sudarkoff/thermostat/eagle/board.png

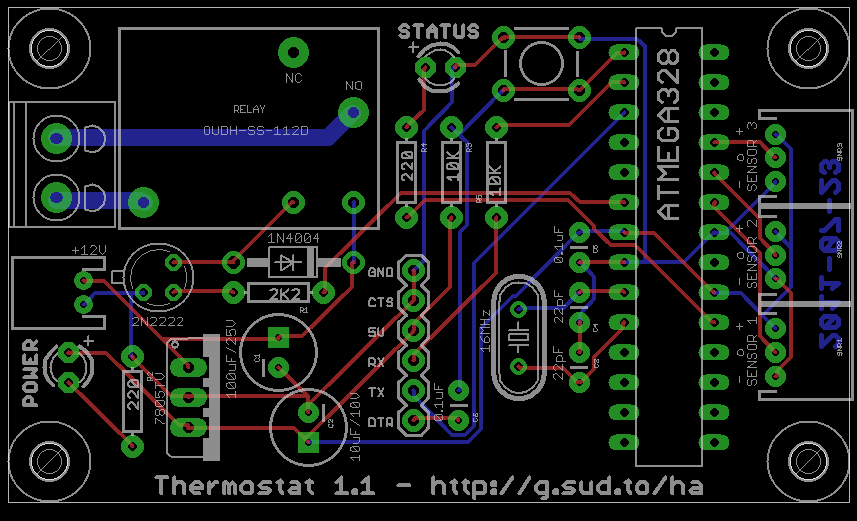
eagle/board.png
