sudarkoff/thermostat/eagle/schematics.png

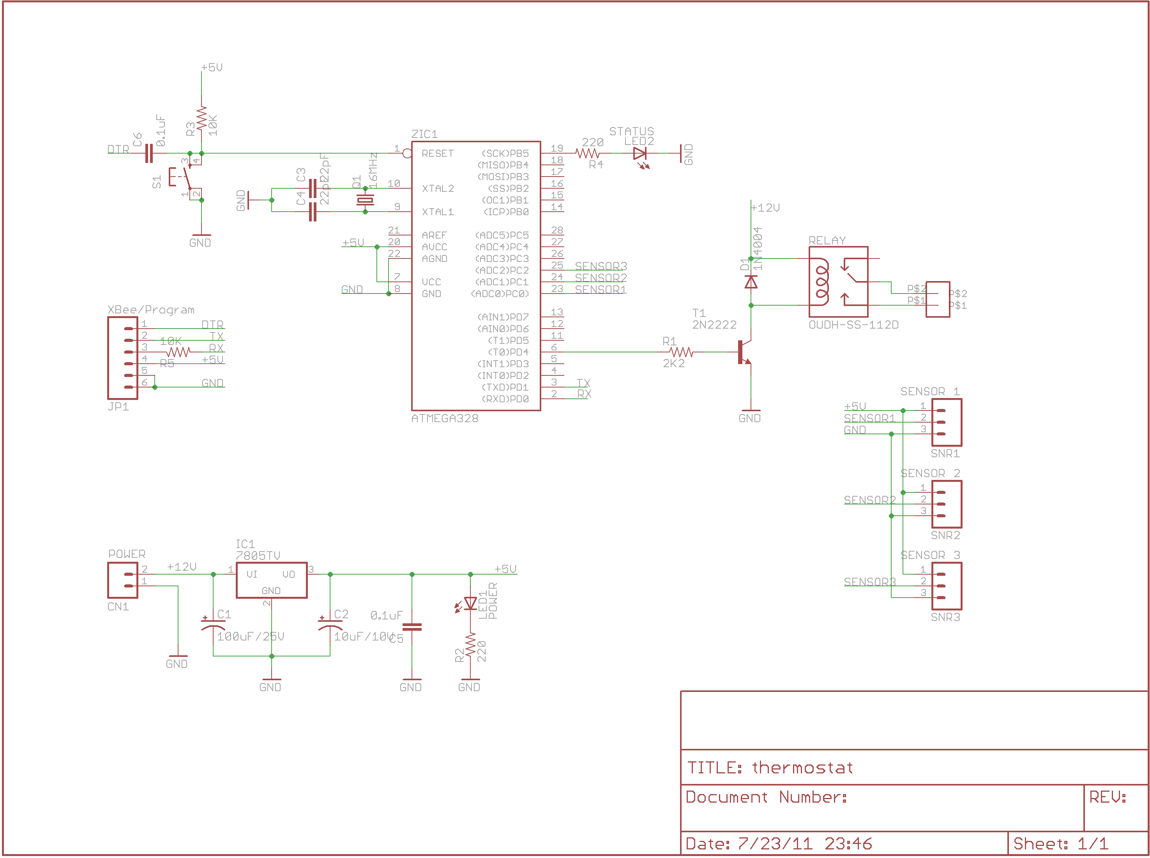
eagle/schematics.png
