sudarkoff/thermostat/(commit log)

2011-07-08 XBeeThermostat V1.0 (PCB ordered from batchpcb.com for proofing and stuff).
    [thermostat.brd, thermostat.sch]
2011-07-09 Committed a bunch of stuff for the first time.
    [thermostat.brd, thermostat.sch]
2011-07-10 Unsuccessful attempt to transmit relay status along with sensor readings. Will have to work on it separately. Otherwise, thermostat is ready for field testing.
2011-07-23 Added LoggerSudarbot that pushes sensor data to the bot.sud.to website.
    [thermostat.sch]
2011-07-24 Fixed a few mechanical errors in schematic (drill holes too small, etc.), changed relay pin from 3 to 4 (to match schematics) and added logging to a file to LoggerSudarbot.
    [thermostat.brd, thermostat.sch]
2011-07-28 Fixed error handling (hopefully in LoggerSudarbot) because the script would not terminate in case of exceptions and therefore launchctl would not restart it. Marked sensor connectors on the board's s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
    [thermostat.brd]
2011-07-28 Separated DEBUG from NO_XBEE in Arduino sketch. Made minor cosmetic twiks to the PCB. Twicked error handling for sudarbot logger one more time.
    [thermostat.brd]
2011-07-29 Added some more debug output to see why the logger doesn't terminate on exceptions.
    [LoggerSudarbot.py]
2011-07-29 Another attempt at fixing logger hanging issue - handle the exception, skip the update and move on - don't try to exit the script and rely on launchctl to restart it.
    [LoggerSudarbot.py]
2011-08-16 Send/read fan status. Enable XBee and RH sensor. Move RH sensor to analog pin 2. Take measurements every 2 min. Throw away 1st measurement because it's very inaccurate for some reason.
2012-02-22 Added images of the PCB and the schematic.
